jsteiner4000/Kabelsuchger-t/gehaeuse/konzept/ansicht_beide.png

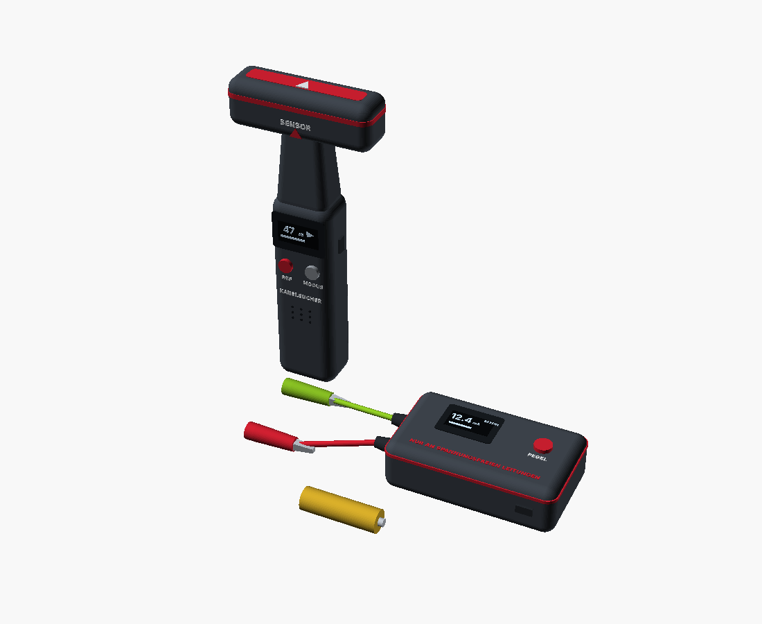
gehaeuse/konzept/ansicht_beide.png
