jsteiner4000/Kabelsuchger-t/gehaeuse/konzept/ansicht_hand.png

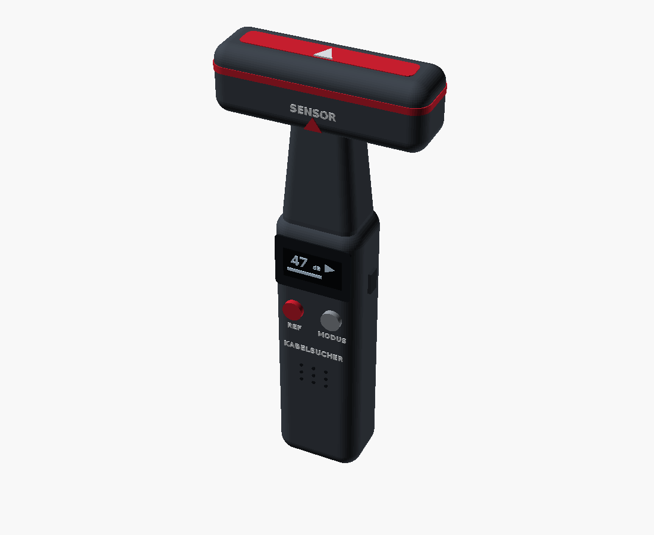
gehaeuse/konzept/ansicht_hand.png
