jsteiner4000/Kabelsuchger-t/hardware/kicad/handgeraet/bilder/handgeraet-bestueckung.png

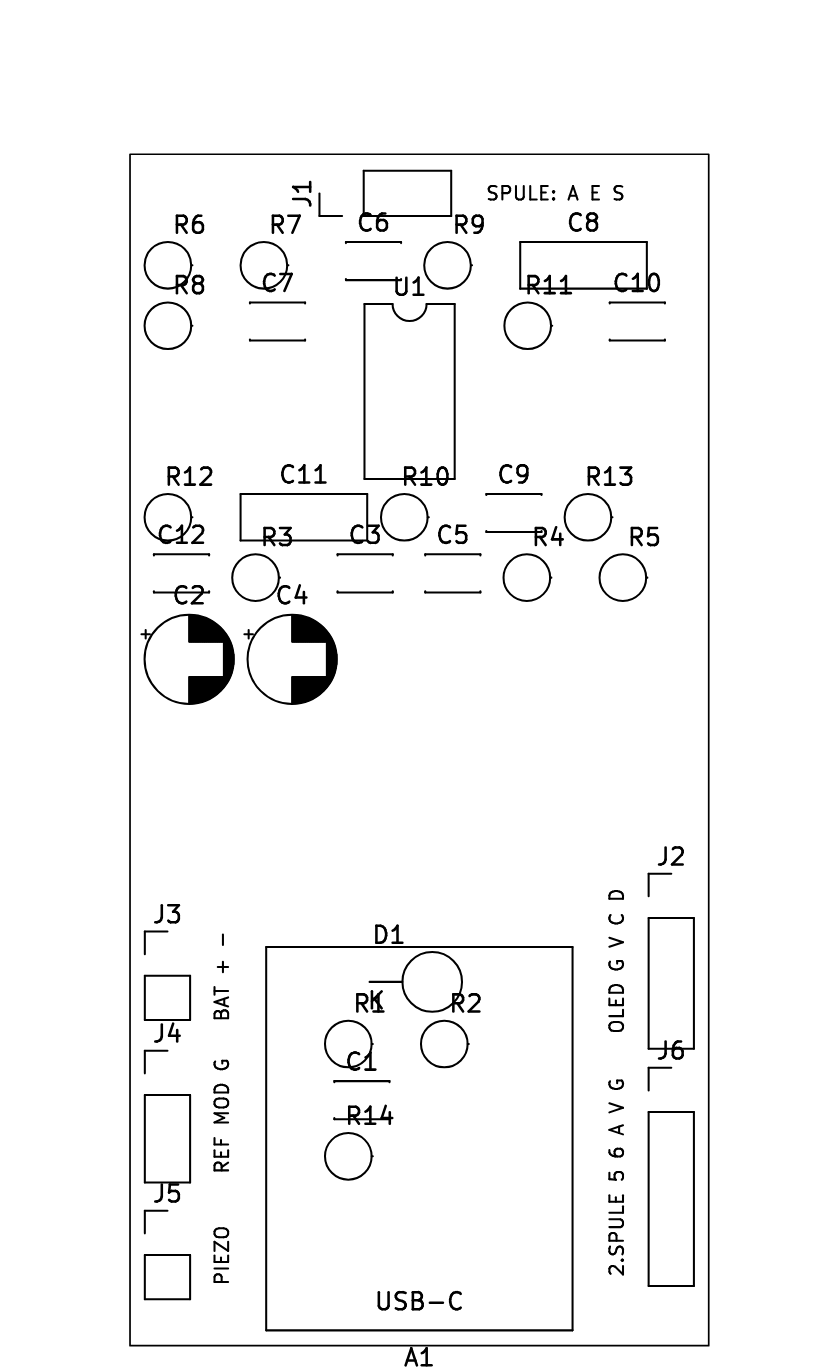
hardware/kicad/handgeraet/bilder/handgeraet-bestueckung.png
