jsteiner4000/Kabelsuchger-t/hardware/kicad/handgeraet/bilder/handgeraet-oben.png

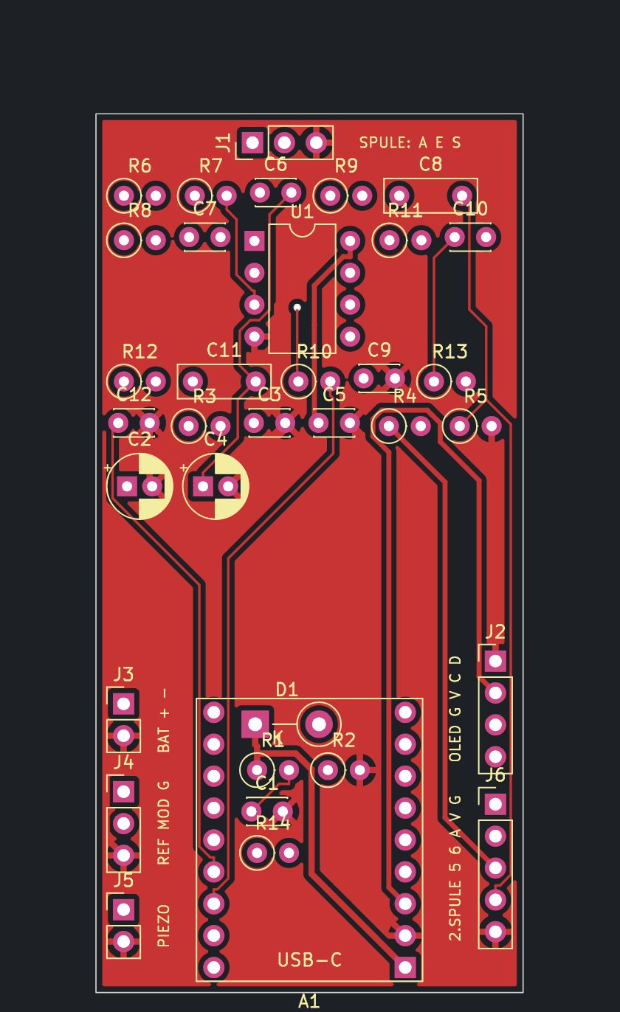
hardware/kicad/handgeraet/bilder/handgeraet-oben.png
