jsteiner4000/Kabelsuchger-t/hardware/kicad/handgeraet/bilder/handgeraet-unten.png

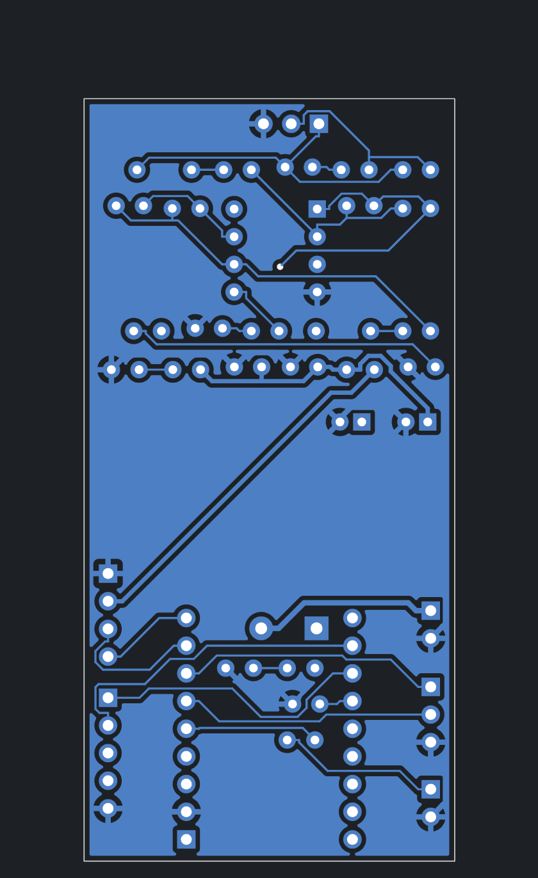
hardware/kicad/handgeraet/bilder/handgeraet-unten.png
