jsteiner4000/Kabelsuchger-t/hardware/kicad/sender/bilder/sender-bestueckung.png

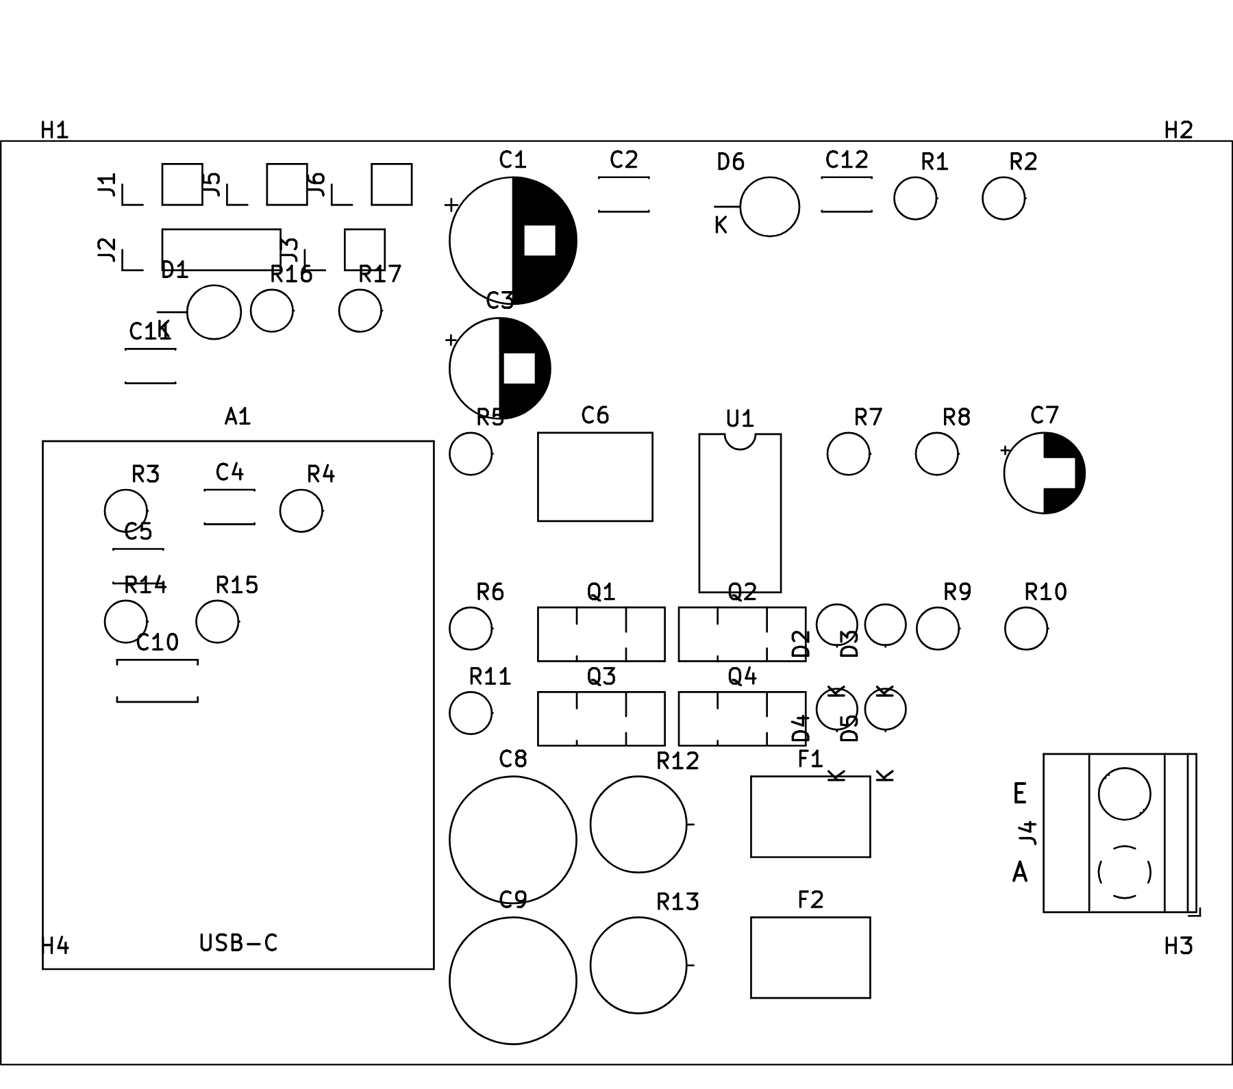
hardware/kicad/sender/bilder/sender-bestueckung.png
