jsteiner4000/Kabelsuchger-t/hardware/kicad/sender/bilder/sender-oben.png

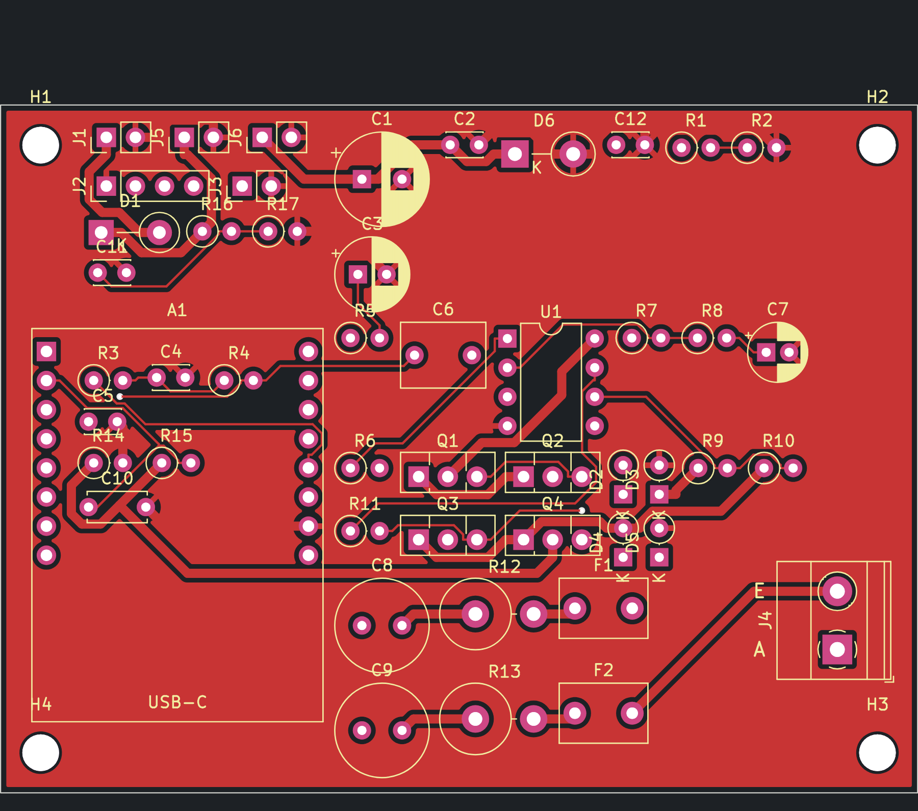
hardware/kicad/sender/bilder/sender-oben.png
