jsteiner4000/Kabelsuchger-t/hardware/kicad/sender/bilder/sender-unten.png

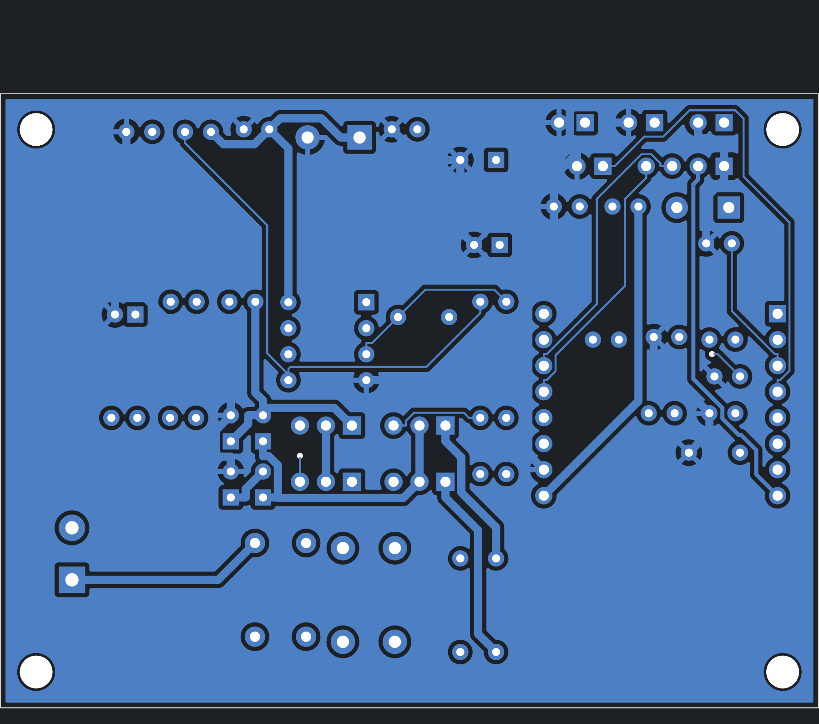
hardware/kicad/sender/bilder/sender-unten.png
