jsteiner4000/Kabelsuchger-t/hardware/handgeraet/spule/spulenkoerper_H.stl

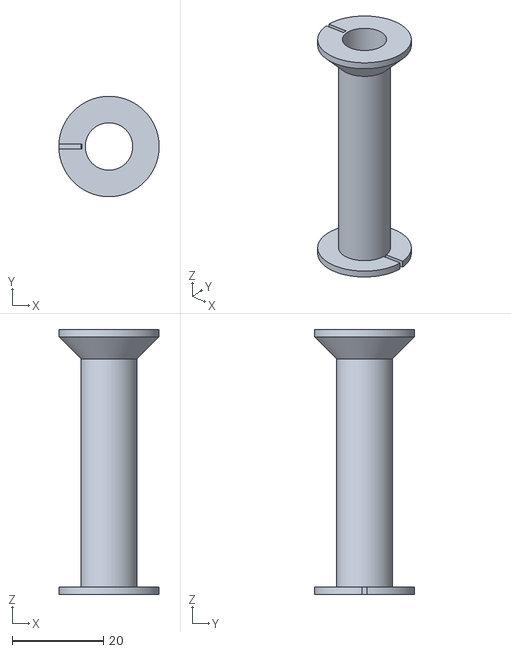
[picture p9: CAD file, 2026-10-13]
hardware/handgeraet/spule/spulenkoerper_H.stl
22.0 x 22.0 x 58.1
