jsteiner4000/Kabelsuchger-t/hardware/handgeraet/testaufbau/messkopf.stl

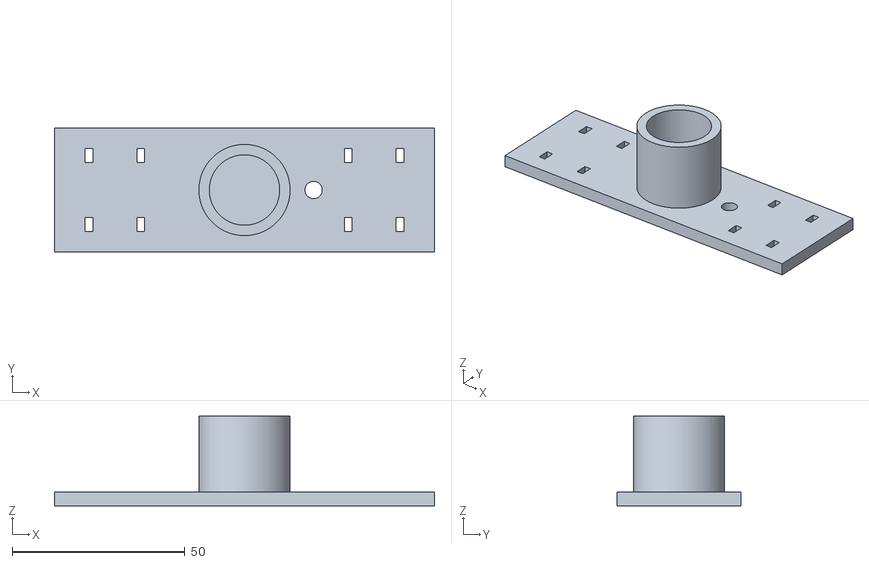
[picture p10: CAD file, 2026-10-13]
hardware/handgeraet/testaufbau/messkopf.stl
110.0 x 36.0 x 26.0
