jsteiner4000/Kabelsuchger-t/hardware/handgeraet/spule/wickeldorn.stl

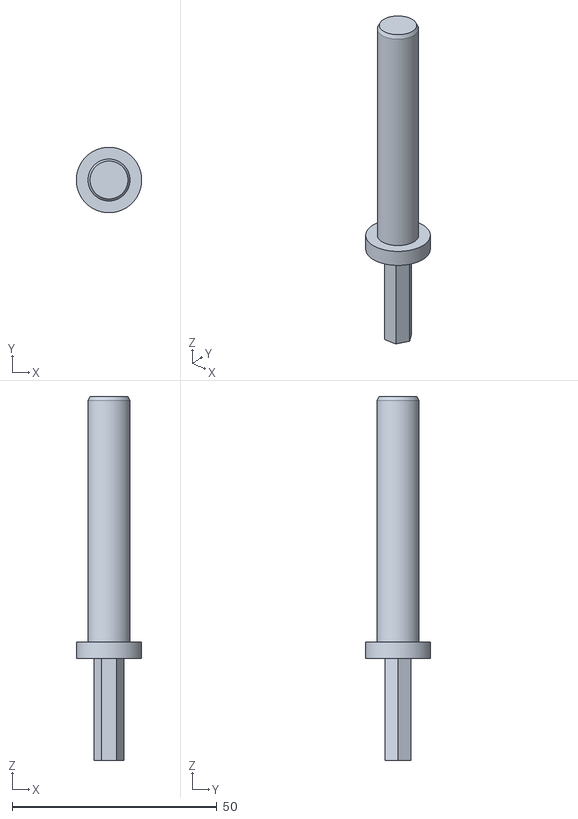
[picture p11: CAD file, 2026-10-13]
hardware/handgeraet/spule/wickeldorn.stl
16.0 x 16.0 x 89.0
