jsteiner4000/Kabelsuchger-t/hardware/handgeraet/spule/spulenkoerper_V.stl

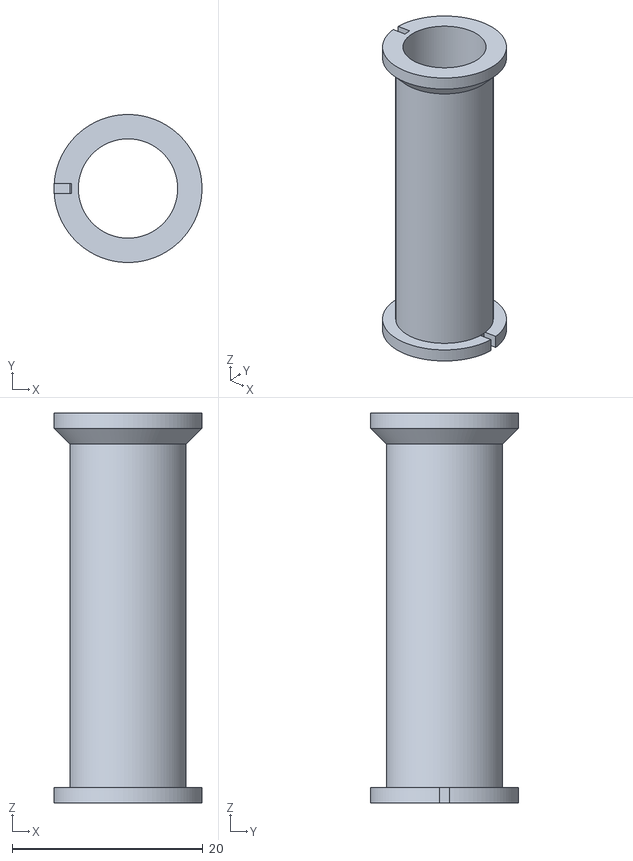
[picture p12: CAD file, 2026-10-13]
hardware/handgeraet/spule/spulenkoerper_V.stl
15.5 x 15.5 x 40.9
