jsteiner4000/Kabelsuchger-t/hardware/kicad/handgeraet/handgeraet-schaltplan.pdf

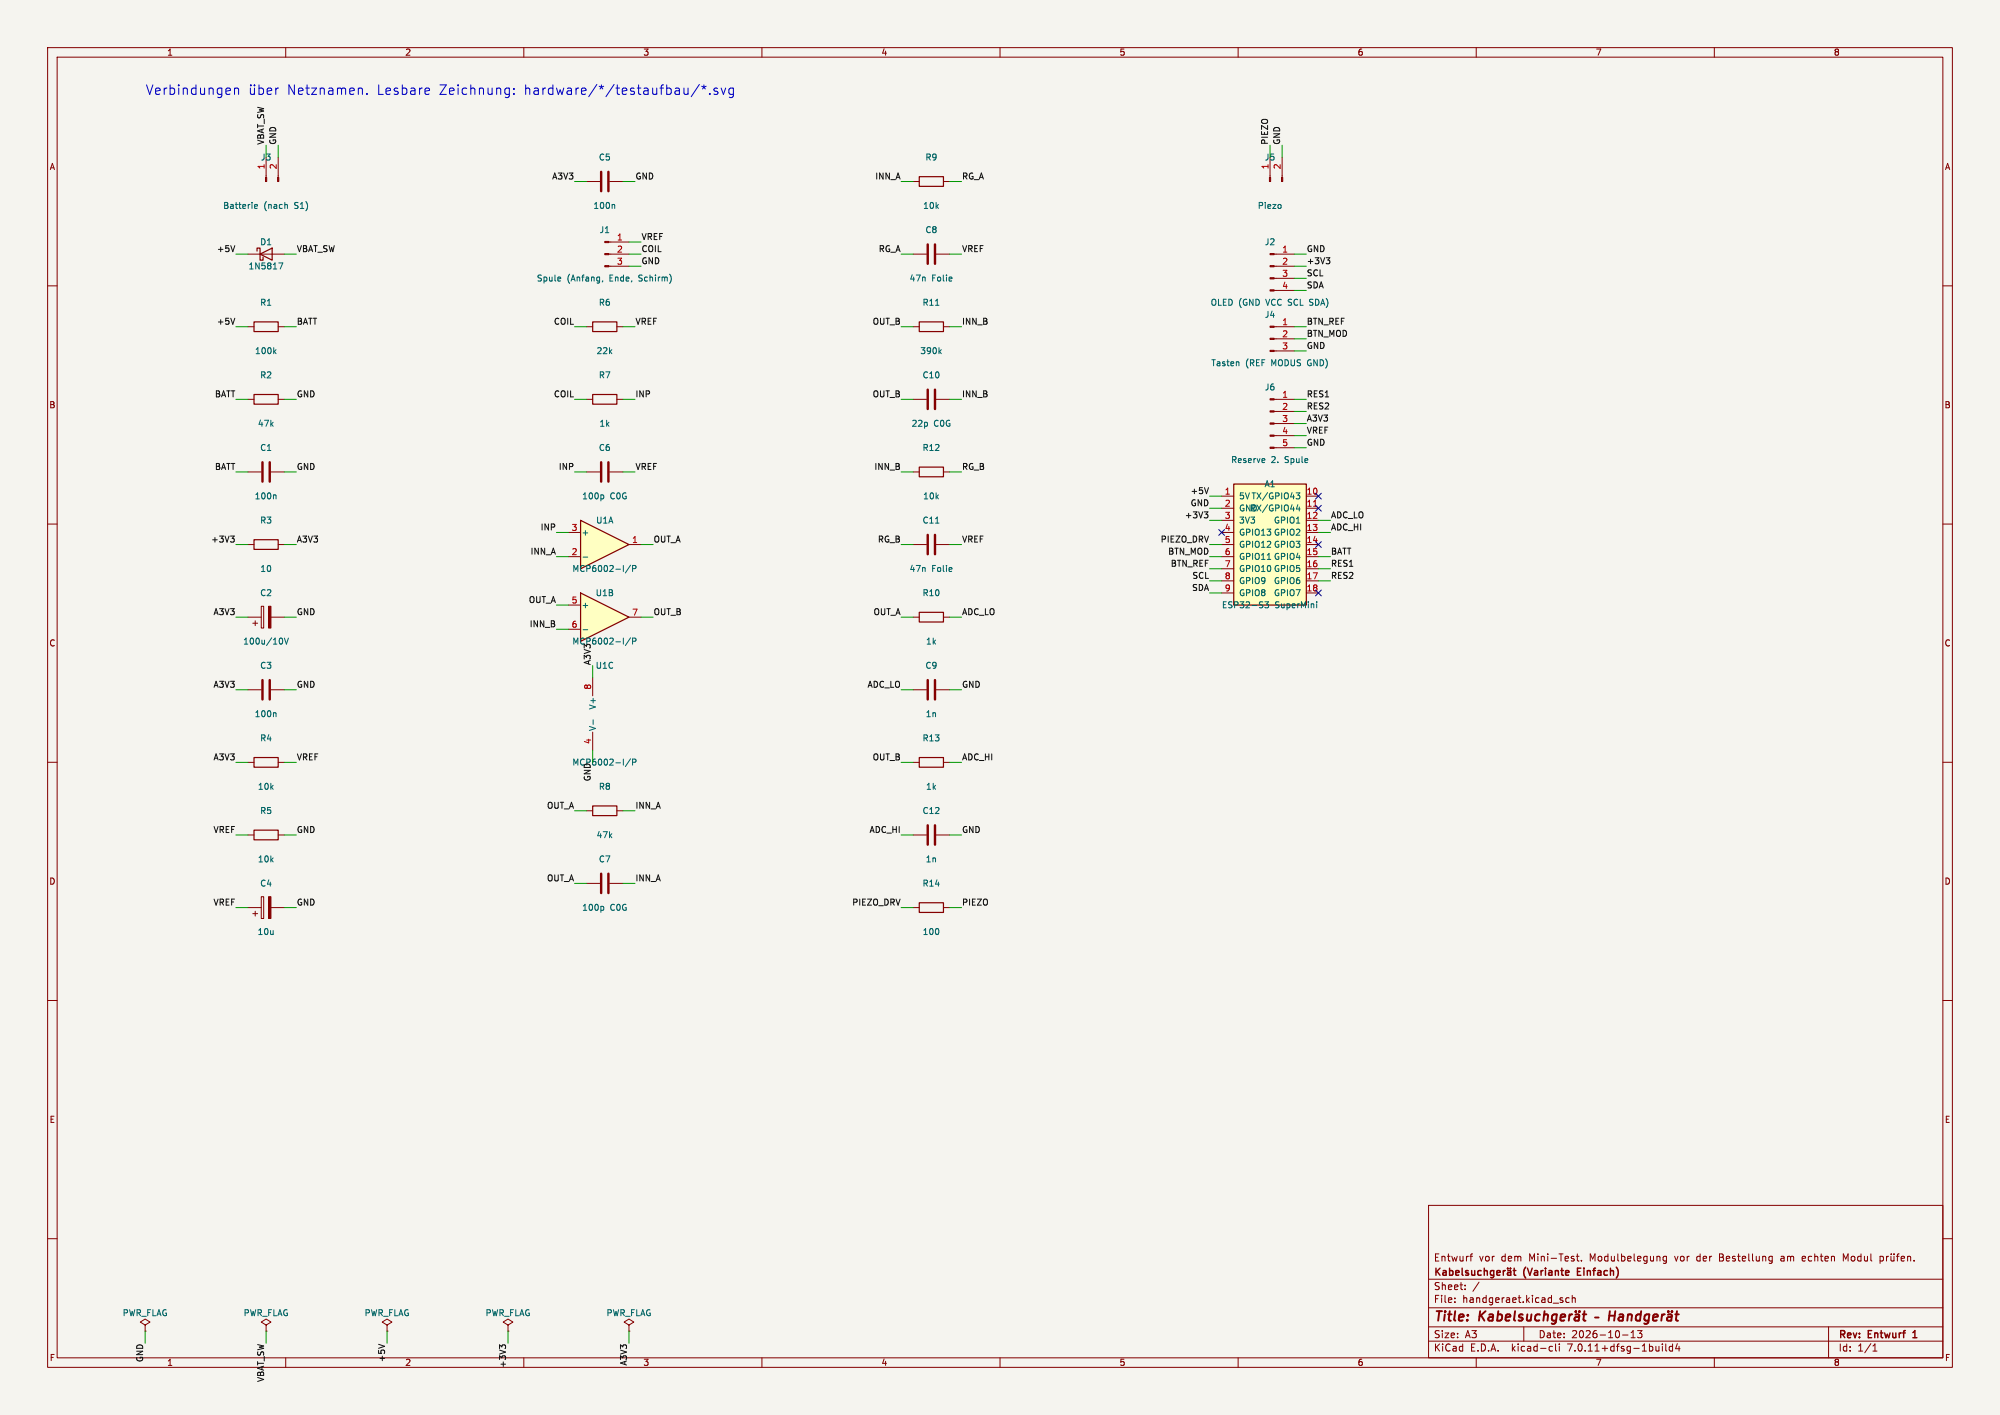
[picture p13: page 1]

J2 OLED (GND VCC SCL SDA) 1

J4 Tasten (REF MODUS GND) C4
