jsteiner4000/Kabelsuchger-t/hardware/kicad/sender/sender-schaltplan.pdf

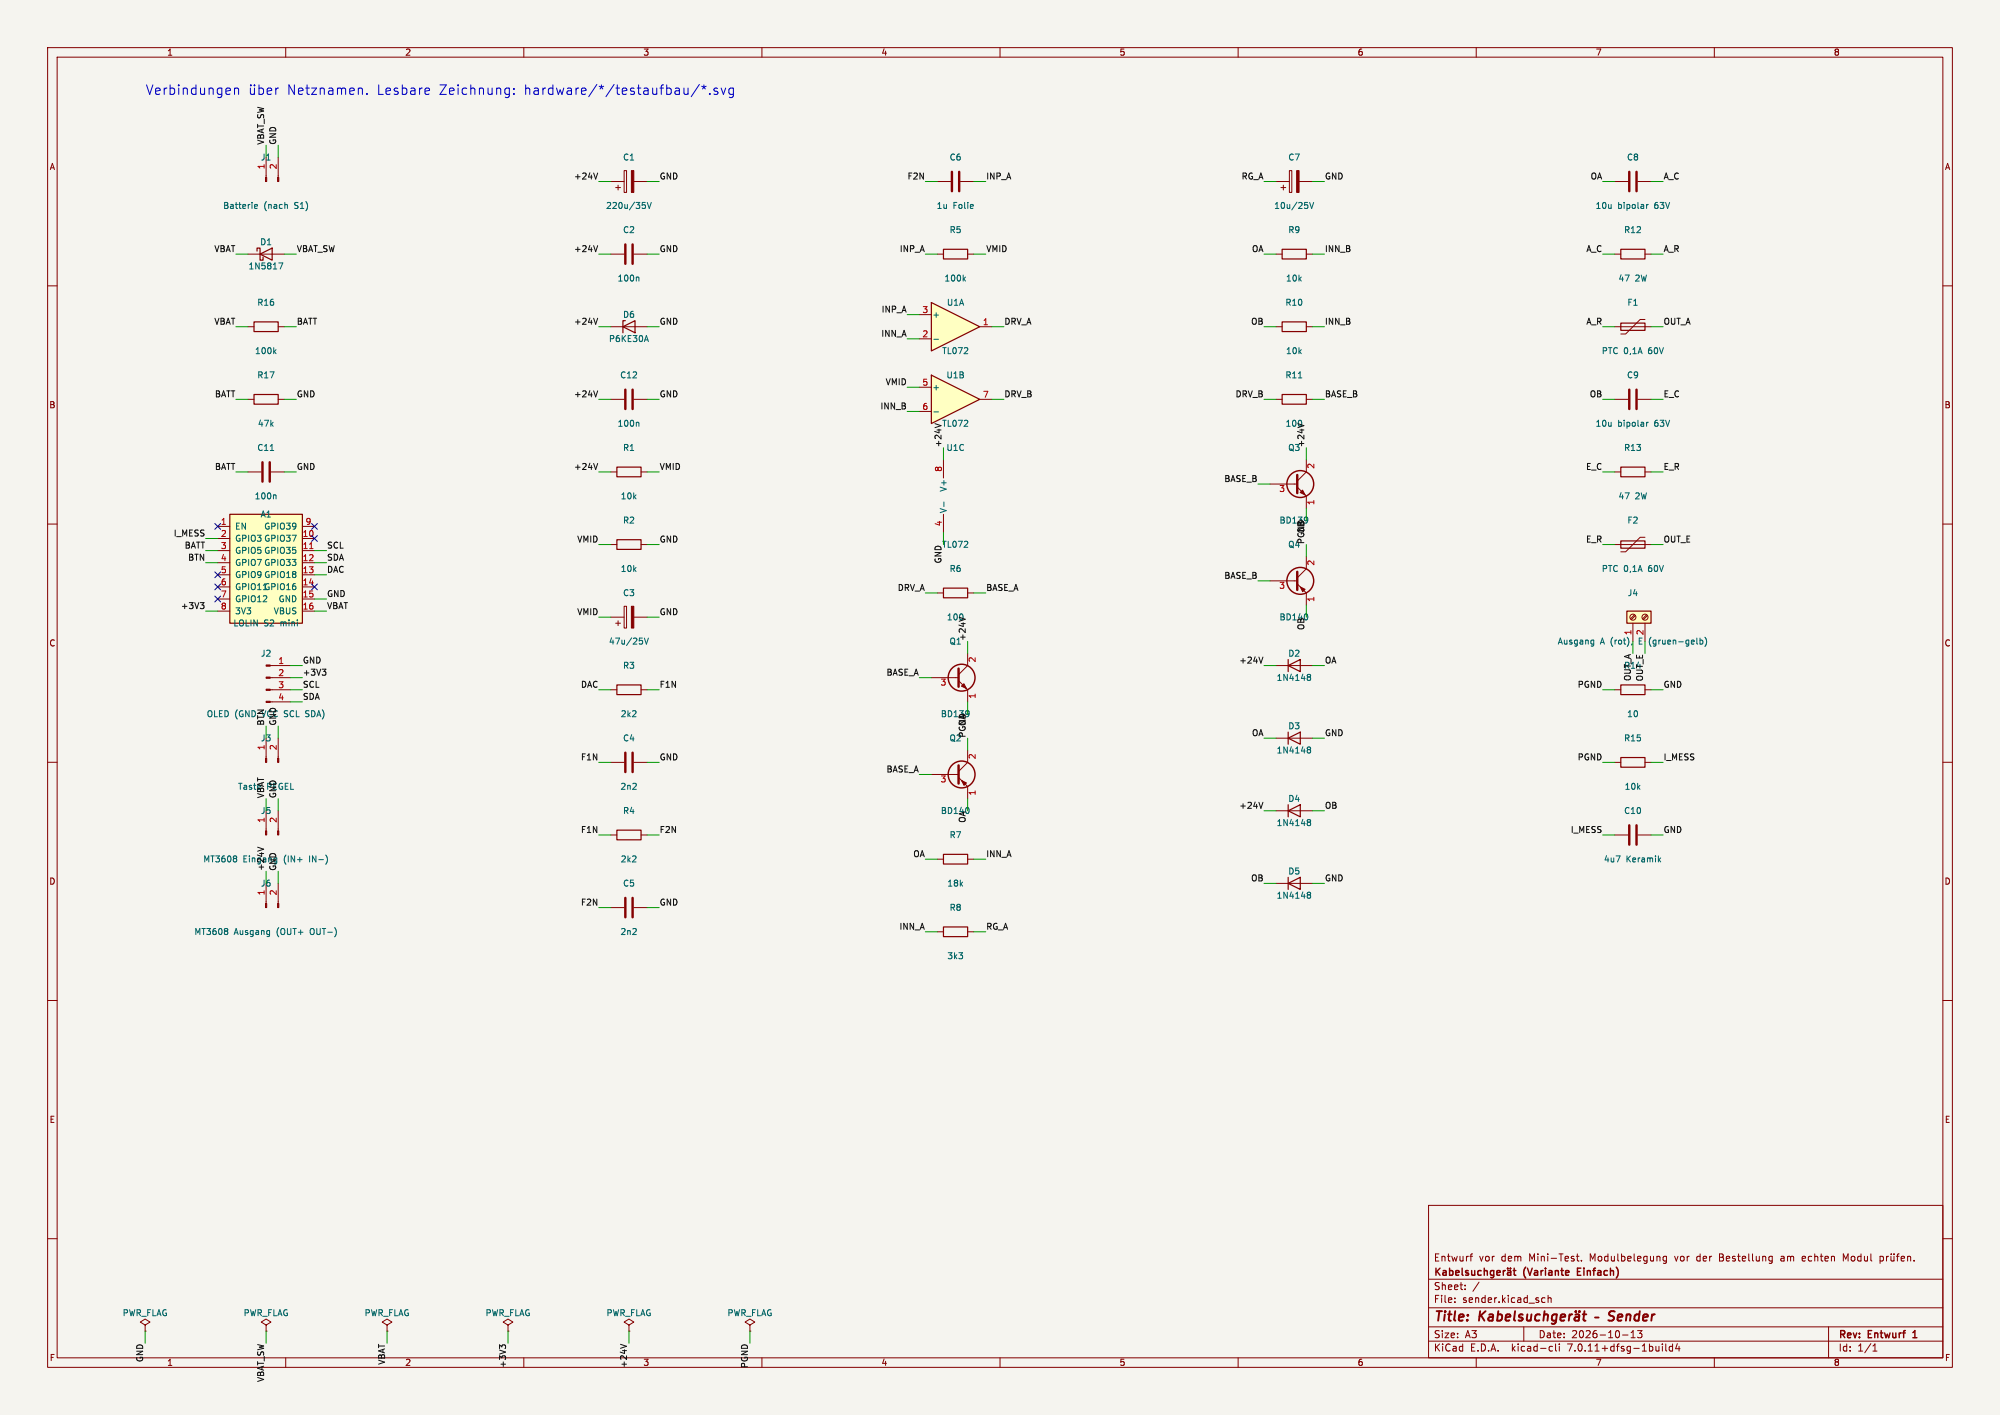
[picture p14: page 1]

J4 Ausgang A (rot), E (gruen-gelb)
