jsteiner4000/Kabelsuchger-t/hardware/kicad/sender/sender.kicad_pcb

## KiCad design hardware/kicad/sender/sender.kicad_pcb (2026-10-13)

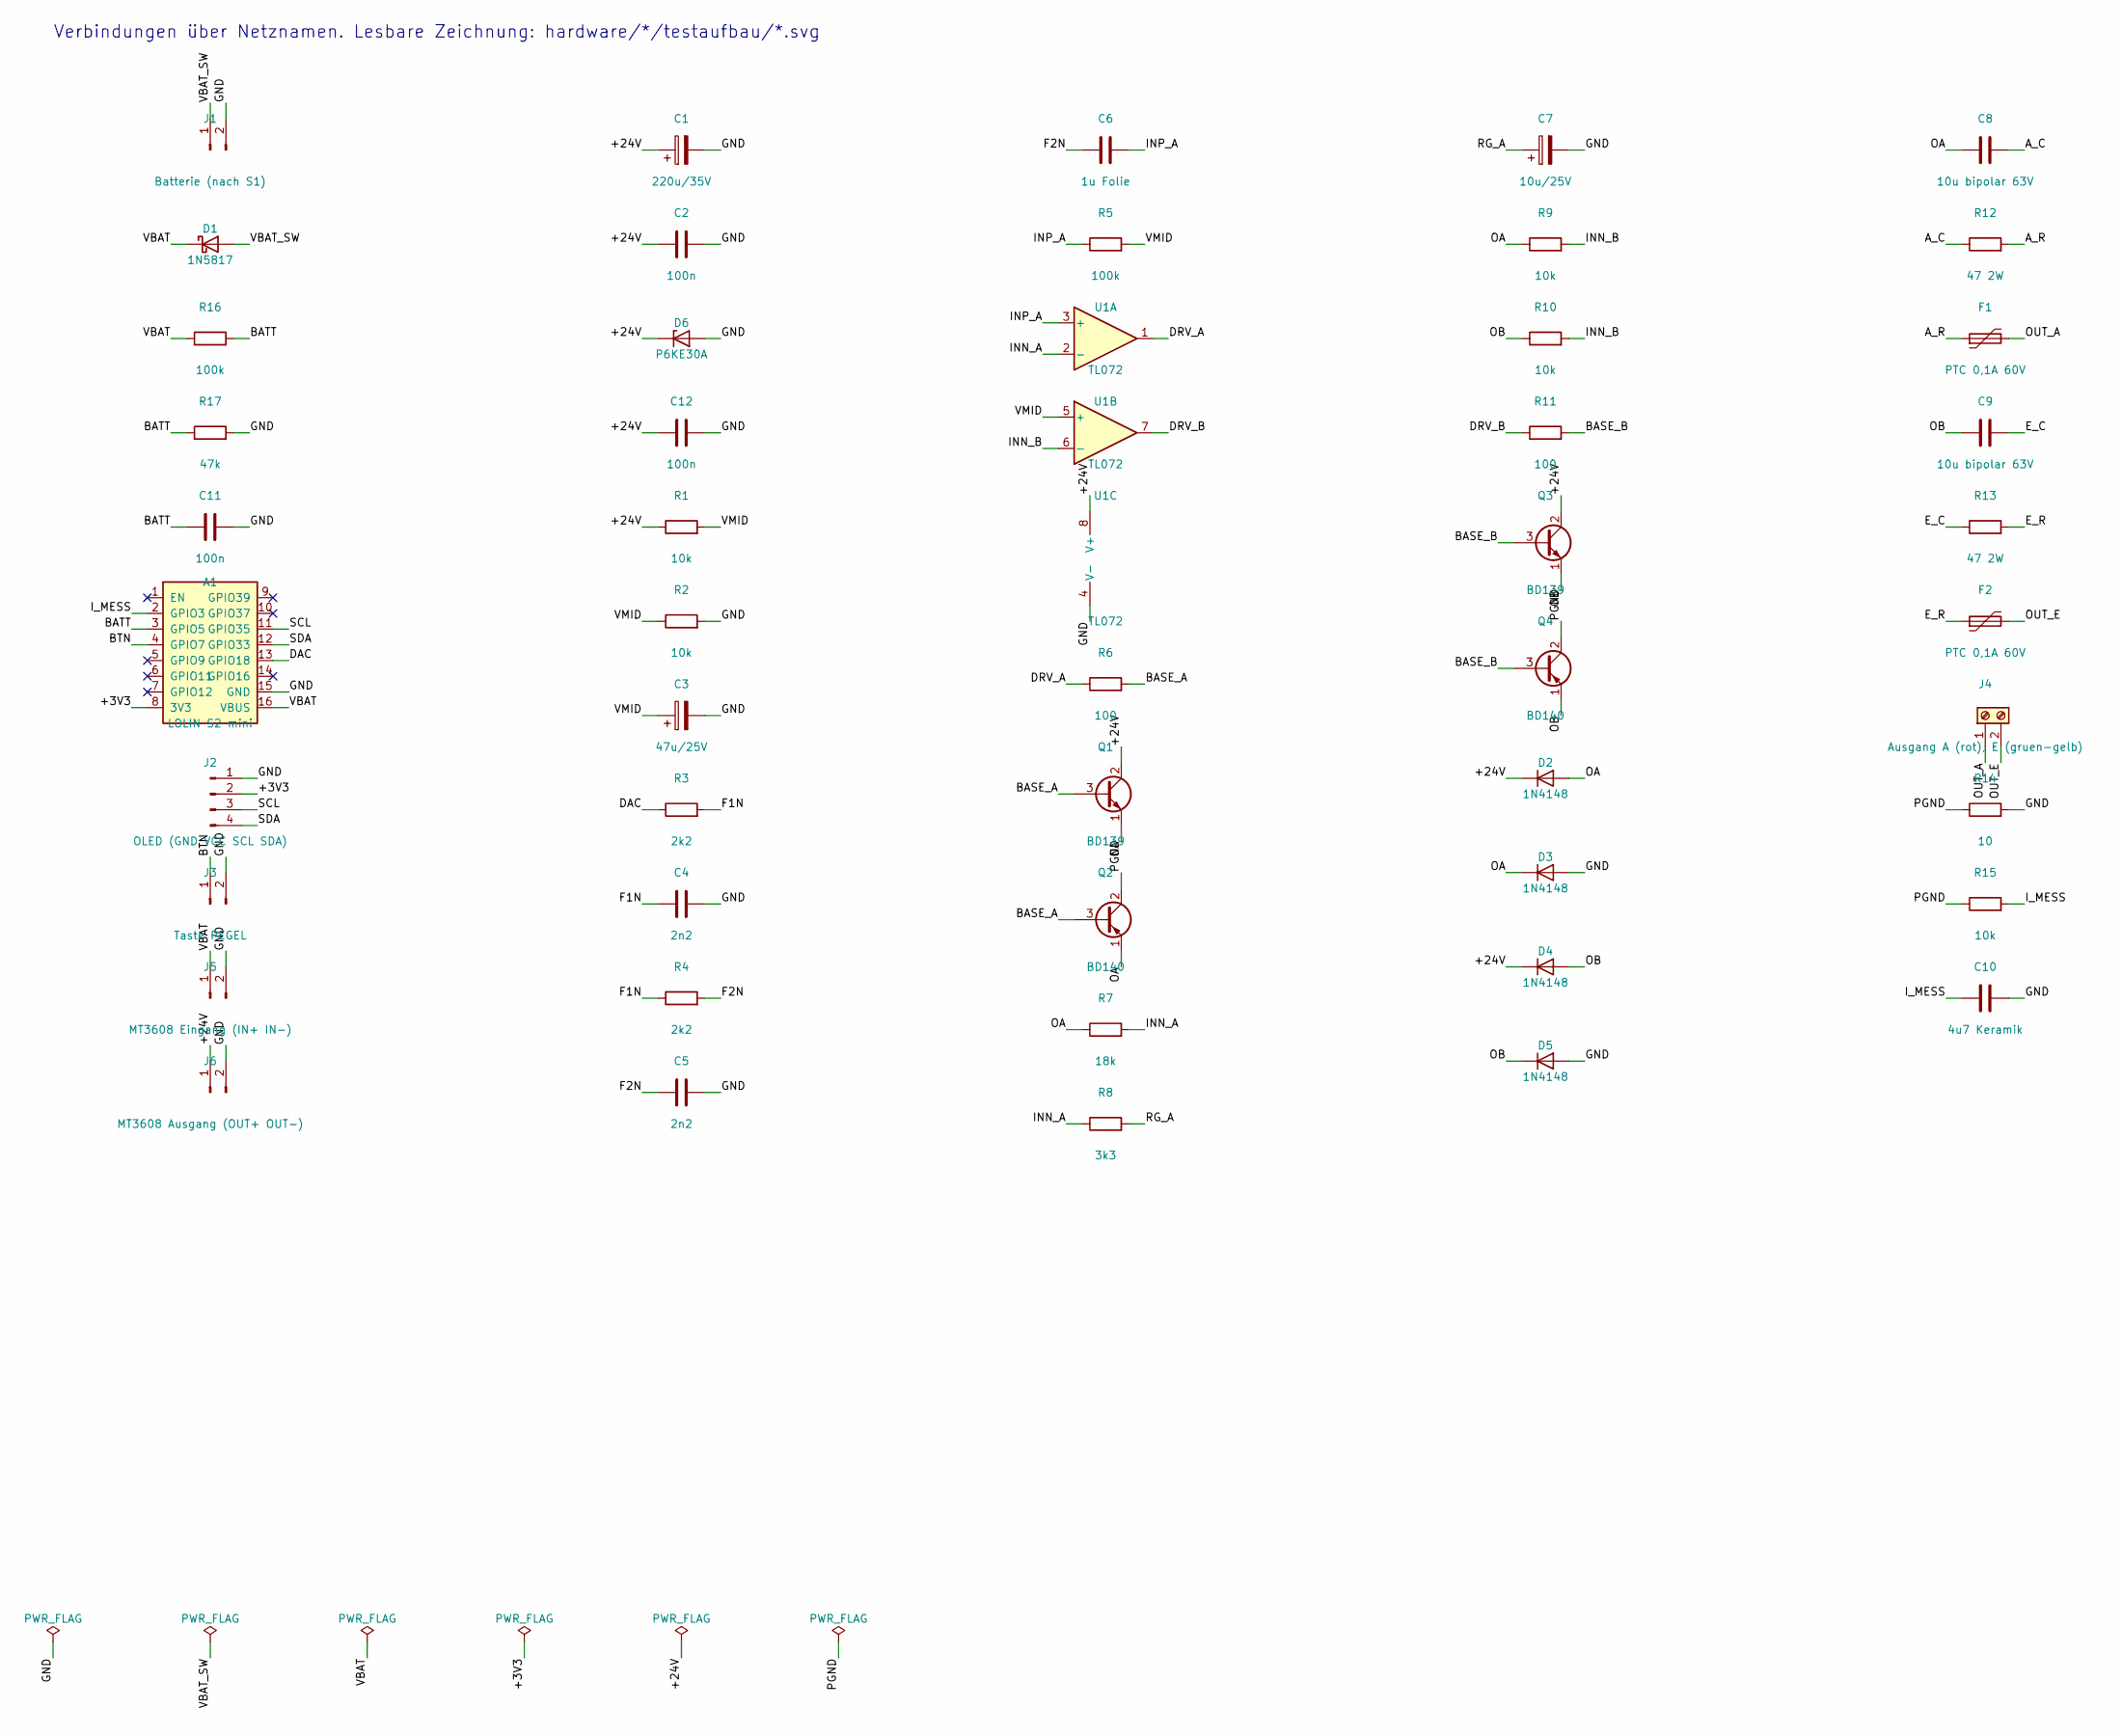
[picture p15: schematic sender.kicad_sch, Kabelsuchgerät – Sender]

Parts:
A1: LOLIN S2 mini; LOLIN_S2_mini
C1: 220u/35V; CP_Radial_D8.0mm_P3.50mm
C2, C11, C12: 100n; C_Disc_D3.0mm_W2.0mm_P2.50mm
C3: 47u/25V; CP_Radial_D6.3mm_P2.50mm
C4, C5: 2n2; C_Disc_D3.0mm_W2.0mm_P2.50mm
C6: 1u Folie; C_Rect_L7.2mm_W5.5mm_P5.00mm_FKS2_FKP2_MKS2_MKP2
C7: 10u/25V; CP_Radial_D5.0mm_P2.00mm
C8, C9: 10u bipolar 63V; C_Radial_D8.0mm_H11.5mm_P3.50mm
C10: 4u7 Keramik; C_Disc_D5.0mm_W2.5mm_P5.00mm
D1: 1N5817; D_DO-41_SOD81_P5.08mm_Vertical_KathodeUp
D2, D3, D4, D5: 1N4148; D_DO-35_SOD27_P2.54mm_Vertical_KathodeUp
D6: P6KE30A; D_DO-15_P5.08mm_Vertical_KathodeUp
F1, F2: PTC 0,1A 60V; C_Disc_D7.5mm_W5.0mm_P5.00mm
J1: Batterie (nach S1); PinHeader_1x02_P2.54mm_Vertical
J2: OLED (GND VCC SCL SDA); PinHeader_1x04_P2.54mm_Vertical
J3: Taste PEGEL; PinHeader_1x02_P2.54mm_Vertical
J4: Ausgang A (rot), E (gruen-gelb); TerminalBlock_Phoenix_MKDS-1,5-2-5.08_1x02_P5.08mm_Horizont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
J5: MT3608 Eingang (IN+ IN-); PinHeader_1x02_P2.54mm_Vertical
J6: MT3608 Ausgang (OUT+ OUT-); PinHeader_1x02_P2.54mm_Vertical
Q1, Q3: BD139; TO-126-3_Vertical
Q2, Q4: BD140; TO-126-3_Vertical
R1, R2, R9, R10, R15: 10k; R_Axial_DIN0207_L6.3mm_D2.5mm_P2.54mm_Vertical
R3, R4: 2k2; R_Axial_DIN0207_L6.3mm_D2.5mm_P2.54mm_Vertical
R5, R16: 100k; R_Axial_DIN0207_L6.3mm_D2.5mm_P2.54mm_Vertical
R6, R11: 100; R_Axial_DIN0207_L6.3mm_D2.5mm_P2.54mm_Vertical
R7: 18k; R_Axial_DIN0207_L6.3mm_D2.5mm_P2.54mm_Vertical
R8: 3k3; R_Axial_DIN0207_L6.3mm_D2.5mm_P2.54mm_Vertical
R12, R13: 47 2W; R_Axial_DIN0617_L17.0mm_D6.0mm_P5.08mm_Vertical
R14: 10; R_Axial_DIN0207_L6.3mm_D2.5mm_P2.54mm_Vertical
R17: 47k; R_Axial_DIN0207_L6.3mm_D2.5mm_P2.54mm_Vertical
U1: TL072; DIP-8_W7.62mm

Connections:
+3V3: A1.8 (3V3), J2.2
+24V: C1.1, C2.1, C12.1, D2.1 (K), D4.1 (K), D6.1 (K), J6.1, Q1.2 (C), Q3.2 (C), R1.1, U1.8 (V+)
A_C: C8.2, R12.1
A_R: F1.1, R12.2
BASE_A: Q1.3 (B), Q2.3 (B), R6.2
BASE_B: Q3.3 (B), Q4.3 (B), R11.2
BATT: A1.3 (GPIO5), C11.1, R16.2, R17.1
BTN: A1.4 (GPIO7), J3.1
DAC: A1.13 (GPIO18), R3.1
DRV_A: R6.1, U1.1
DRV_B: R11.1, U1.7
E_C: C9.2, R13.1
E_R: F2.1, R13.2
F1N: C4.1, R3.2, R4.1
F2N: C5.1, C6.1, R4.2
GND: A1.15 (GND), C1.2, C2.2, C3.2, C4.2, C5.2, C7.2, C10.2, C11.2, C12.2, D3.2 (A), D5.2 (A), D6.2 (A), J1.2, J2.1, J3.2, J5.2, J6.2, R2.2, R14.2, R17.2, U1.4 (V-)
INN_A: R7.2, R8.1, U1.2 (-)
INN_B: R9.2, R10.2, U1.6 (-)
INP_A: C6.2, R5.1, U1.3 (+)
I_MESS: A1.2 (GPIO3), C10.1, R15.2
OA: C8.1, D2.2 (A), D3.1 (K), Q1.1 (E), Q2.1 (E), R7.1, R9.1
OB: C9.1, D4.2 (A), D5.1 (K), Q3.1 (E), Q4.1 (E), R10.1
OUT_A: F1.2, J4.1
OUT_E: F2.2, J4.2
PGND: Q2.2 (C), Q4.2 (C), R14.1, R15.1
RG_A: C7.1, R8.2
SCL: A1.11 (GPIO35), J2.3
SDA: A1.12 (GPIO33), J2.4
VBAT: A1.16 (VBUS), D1.1 (K), J5.1, R16.1
VBAT_SW: D1.2 (A), J1.1
VMID: C3.1, R1.2, R2.1, R5.2, U1.5 (+)

Notes on the sheet:
Verbindungen über Netznamen. Lesbare Zeichnung: hardware/*/testaufbau/*.svg

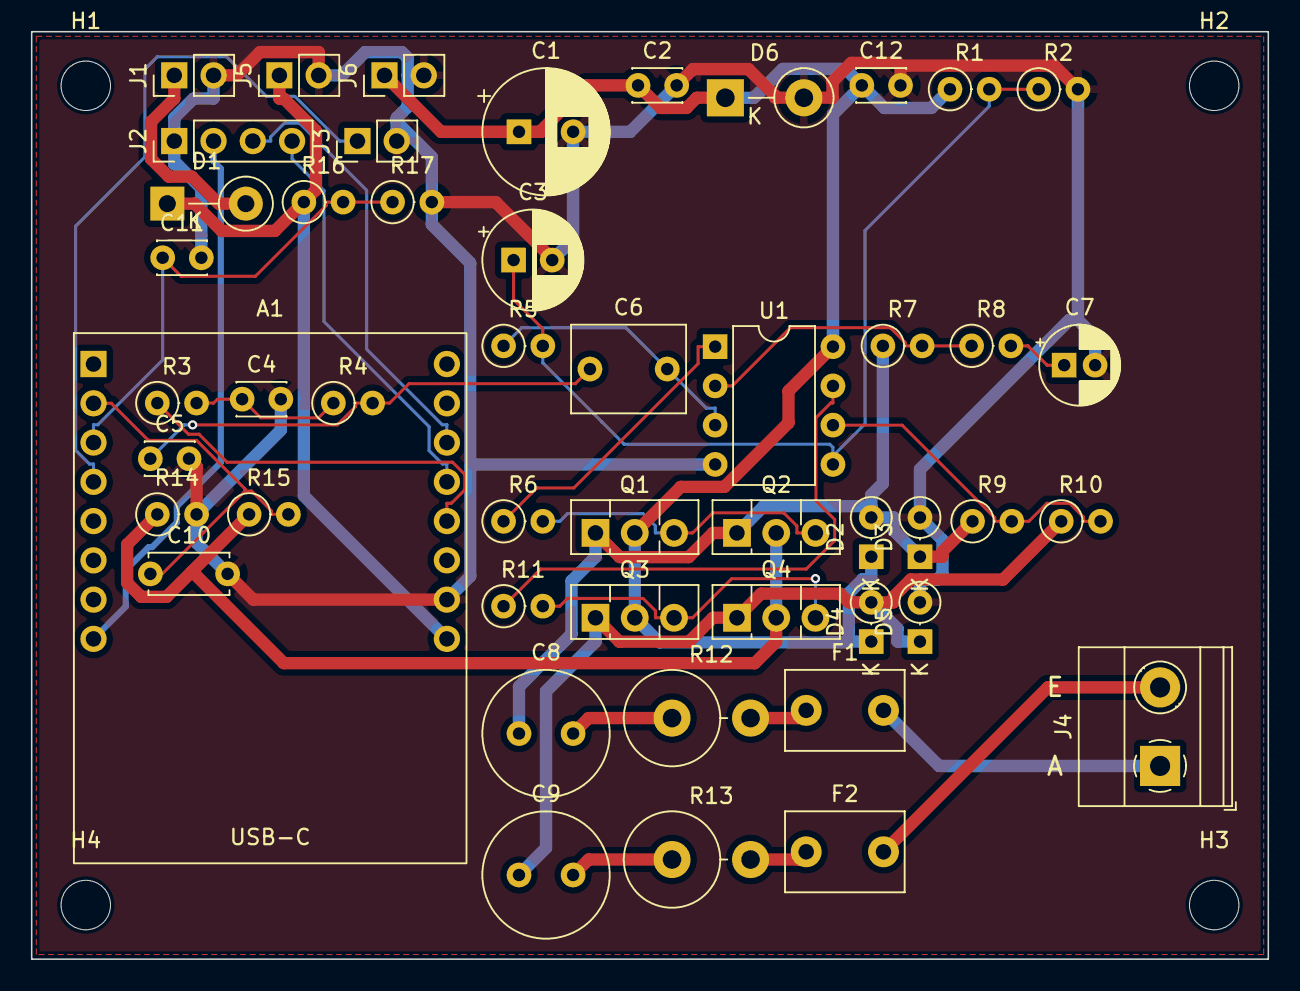
[picture p16: board sender.kicad_pcb from above]

Board: 2 copper layers, 80.0 x 60.0 mm, 53 parts (0 on the bottom side), 31 nets.

Other parts of the board:
H1, H2, H3, H4: M3; MountingHole_3.2mm_M3
