jsteiner4000/Kabelsuchger-t/hardware/kicad/handgeraet/handgeraet.kicad_pcb

## KiCad design hardware/kicad/handgeraet/handgeraet.kicad_pcb (2026-10-13)

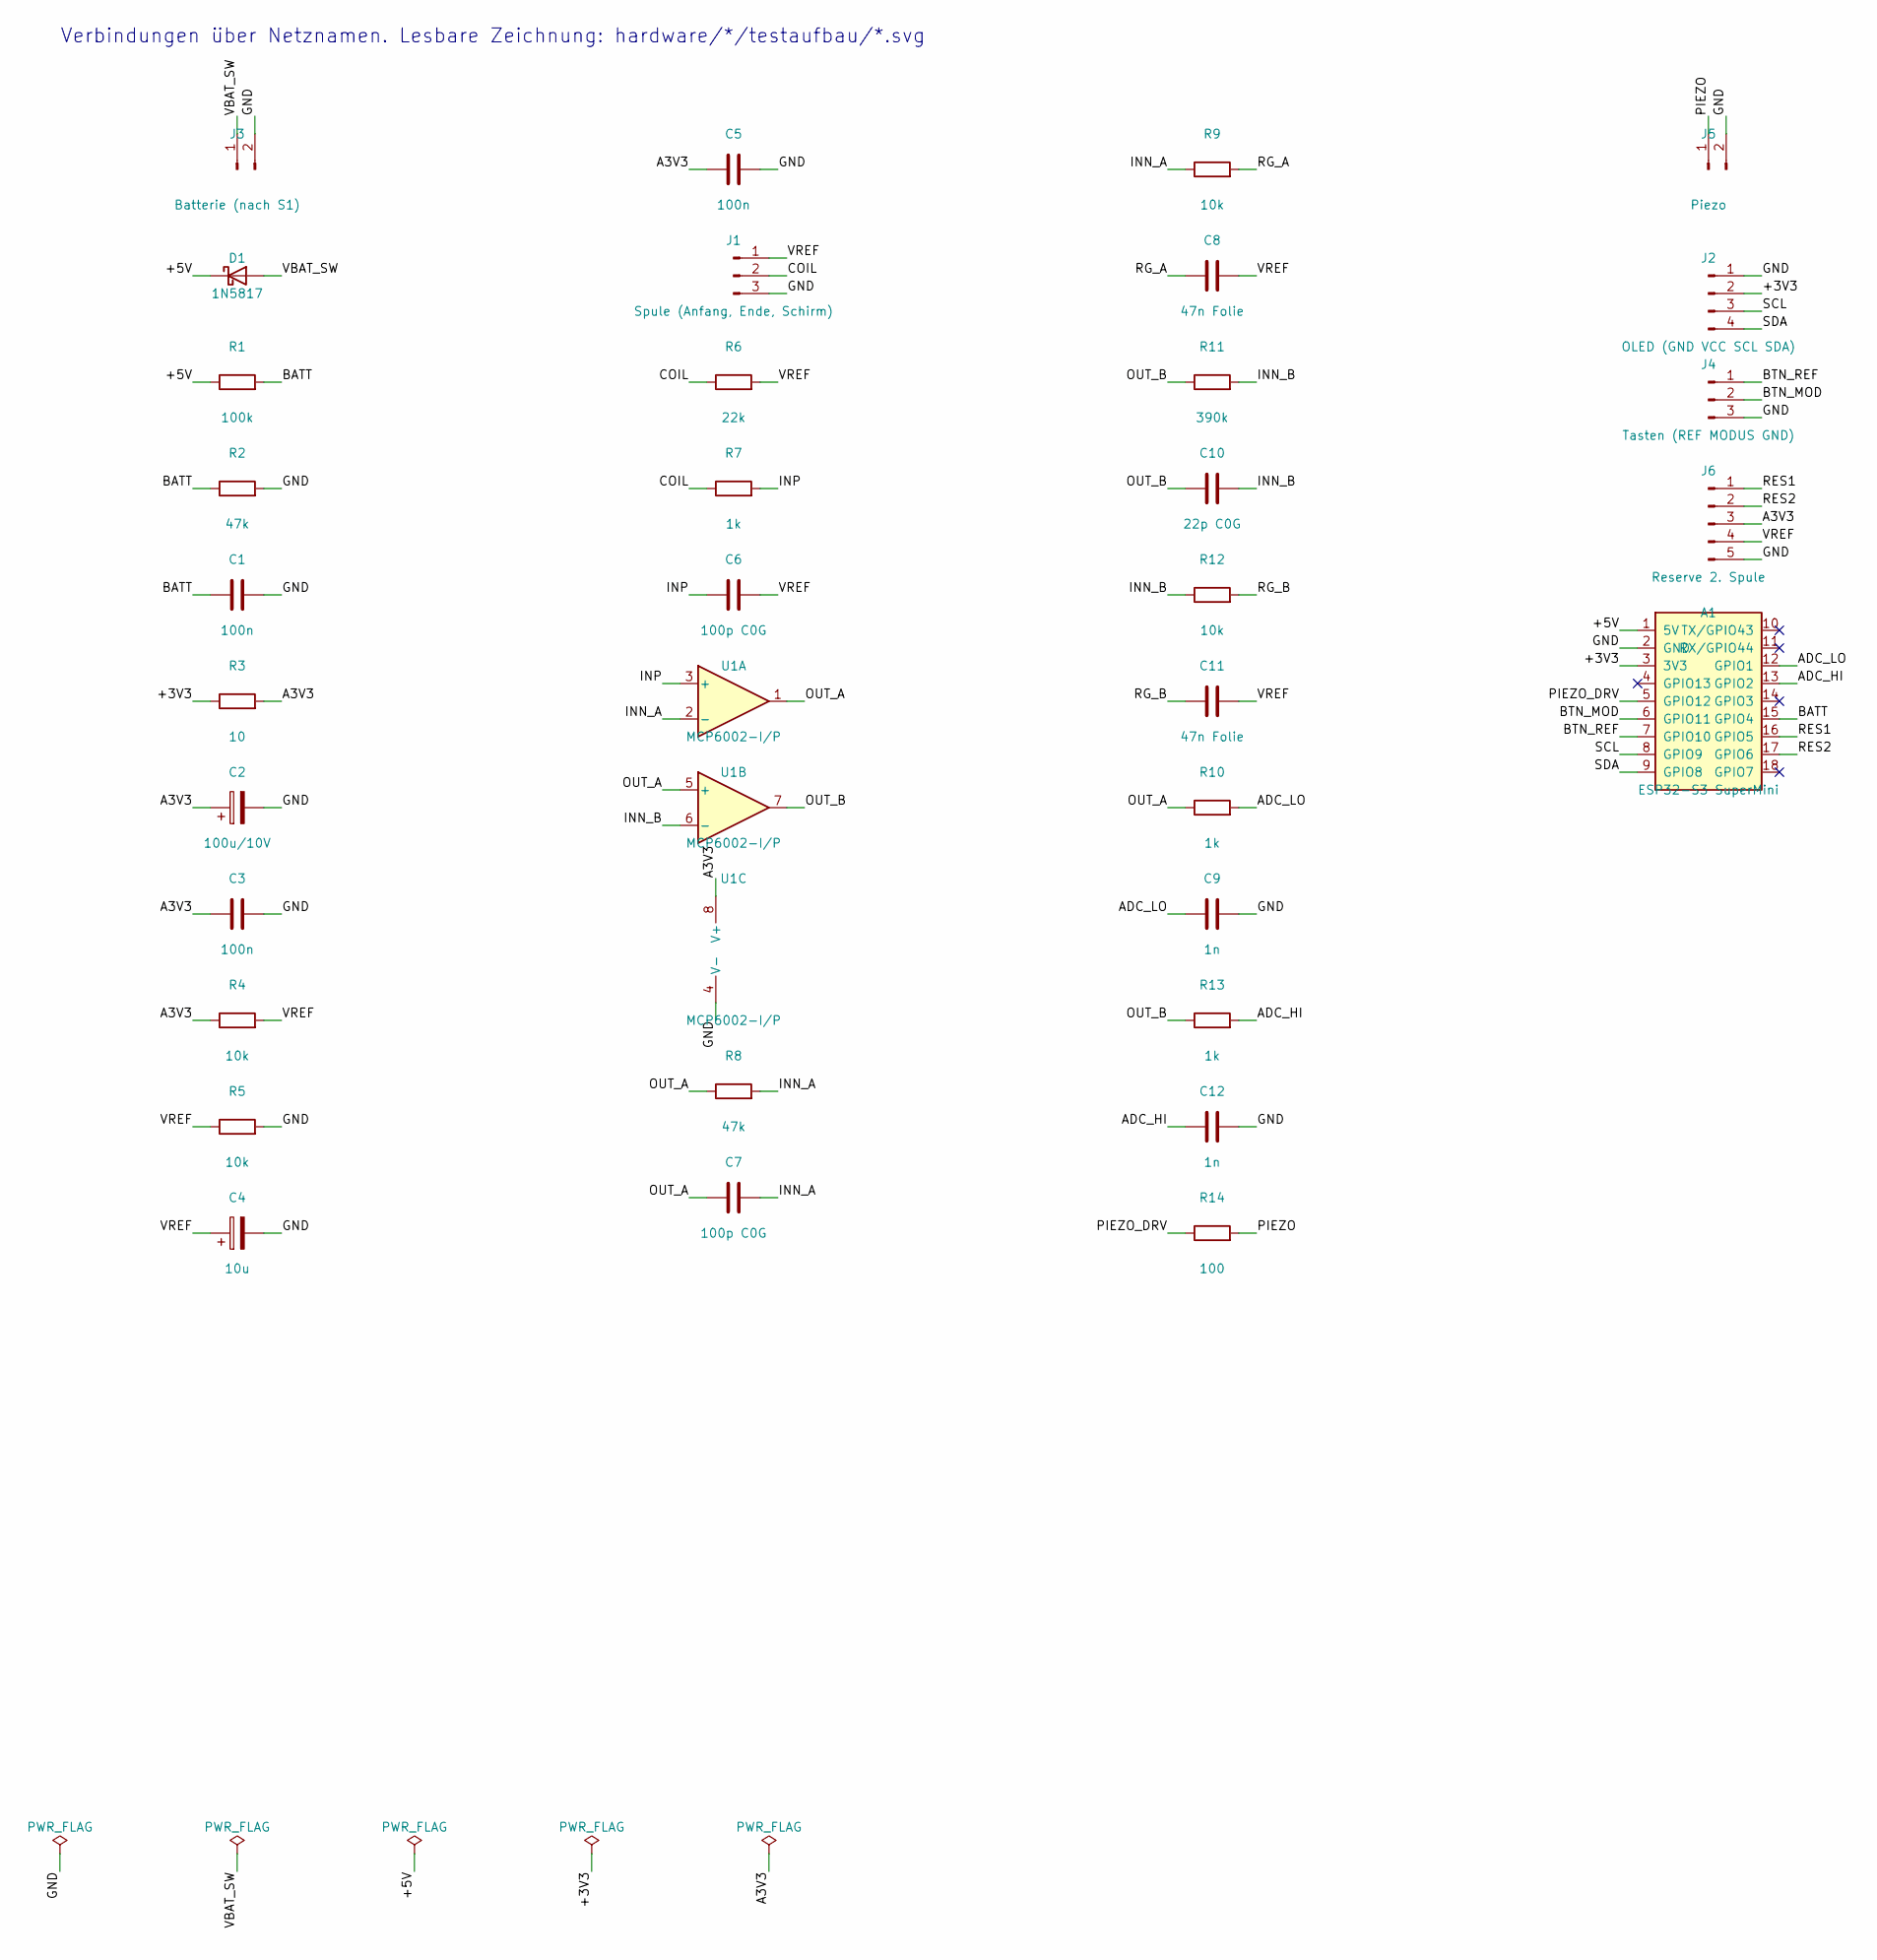
[picture p17: schematic handgeraet.kicad_sch, Kabelsuchgerät – Handgerät]

Parts:
A1: ESP32-S3 SuperMini; ESP32-S3_SuperMini
C1, C3, C5: 100n; C_Disc_D3.0mm_W2.0mm_P2.50mm
C2: 100u/10V; CP_Radial_D5.0mm_P2.00mm
C4: 10u; CP_Radial_D5.0mm_P2.00mm
C6, C7: 100p C0G; C_Disc_D3.0mm_W2.0mm_P2.50mm
C8, C11: 47n Folie; C_Rect_L7.2mm_W2.5mm_P5.00mm_FKS2_FKP2_MKS2_MKP2
C9, C12: 1n; C_Disc_D3.0mm_W2.0mm_P2.50mm
C10: 22p C0G; C_Disc_D3.0mm_W2.0mm_P2.50mm
D1: 1N5817; D_DO-41_SOD81_P5.08mm_Vertical_KathodeUp
J1: Spule (Anfang, Ende, Schirm); PinHeader_1x03_P2.54mm_Vertical
J2: OLED (GND VCC SCL SDA); PinHeader_1x04_P2.54mm_Vertical
J3: Batterie (nach S1); PinHeader_1x02_P2.54mm_Vertical
J4: Tasten (REF MODUS GND); PinHeader_1x03_P2.54mm_Vertical
J5: Piezo; PinHeader_1x02_P2.54mm_Vertical
J6: Reserve 2. Spule; PinHeader_1x05_P2.54mm_Vertical
R1: 100k; R_Axial_DIN0207_L6.3mm_D2.5mm_P2.54mm_Vertical
R2, R8: 47k; R_Axial_DIN0207_L6.3mm_D2.5mm_P2.54mm_Vertical
R3: 10; R_Axial_DIN0207_L6.3mm_D2.5mm_P2.54mm_Vertical
R4, R5, R9, R12: 10k; R_Axial_DIN0207_L6.3mm_D2.5mm_P2.54mm_Vertical
R6: 22k; R_Axial_DIN0207_L6.3mm_D2.5mm_P2.54mm_Vertical
R7, R10, R13: 1k; R_Axial_DIN0207_L6.3mm_D2.5mm_P2.54mm_Vertical
R11: 390k; R_Axial_DIN0207_L6.3mm_D2.5mm_P2.54mm_Vertical
R14: 100; R_Axial_DIN0207_L6.3mm_D2.5mm_P2.54mm_Vertical
U1: MCP6002-I/P; DIP-8_W7.62mm

Connections:
+3V3: A1.3 (3V3), J2.2, R3.1
+5V: A1.1 (5V), D1.1 (K), R1.1
A3V3: C2.1, C3.1, C5.1, J6.3, R3.2, R4.1, U1.8 (V+)
ADC_HI: A1.13 (GPIO2), C12.1, R13.2
ADC_LO: A1.12 (GPIO1), C9.1, R10.2
BATT: A1.15 (GPIO4), C1.1, R1.2, R2.1
BTN_MOD: A1.6 (GPIO11), J4.2
BTN_REF: A1.7 (GPIO10), J4.1
COIL: J1.2, R6.1, R7.1
GND: A1.2 (GND), C1.2, C2.2, C3.2, C4.2, C5.2, C9.2, C12.2, J1.3, J2.1, J3.2, J4.3, J5.2, J6.5, R2.2, R5.2, U1.4 (V-)
INN_A: C7.2, R8.2, R9.1, U1.2 (-)
INN_B: C10.2, R11.2, R12.1, U1.6 (-)
INP: C6.1, R7.2, U1.3 (+)
OUT_A: C7.1, R8.1, R10.1, U1.1, U1.5 (+)
OUT_B: C10.1, R11.1, R13.1, U1.7
PIEZO: J5.1, R14.2
PIEZO_DRV: A1.5 (GPIO12), R14.1
RES1: A1.16 (GPIO5), J6.1
RES2: A1.17 (GPIO6), J6.2
RG_A: C8.1, R9.2
RG_B: C11.1, R12.2
SCL: A1.8 (GPIO9), J2.3
SDA: A1.9 (GPIO8), J2.4
VBAT_SW: D1.2 (A), J3.1
VREF: C4.1, C6.2, C8.2, C11.2, J1.1, J6.4, R4.2, R5.1, R6.2

Notes on the sheet:
Verbindungen über Netznamen. Lesbare Zeichnung: hardware/*/testaufbau/*.svg

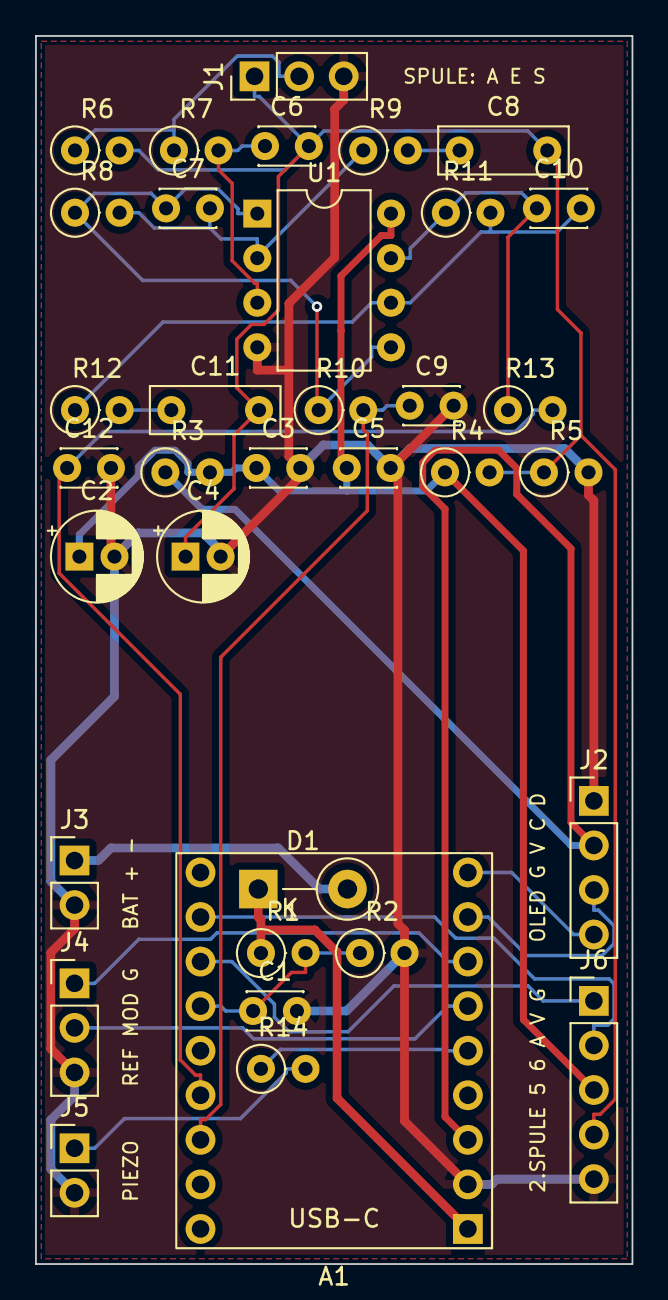
[picture p18: board handgeraet.kicad_pcb from above]

Board: 2 copper layers, 34.0 x 70.0 mm, 35 parts (0 on the bottom side), 25 nets.
