jsteiner4000/Kabelsuchger-t/firmware/machbarkeit/test_host/stubs/soc/soc_caps.h

// Ersatz: Werte für den ESP32-S3 aus ESP-IDF v5.3 soc/esp32s3/include/soc/soc_caps.h
#pragma once
#define SOC_ADC_DIGI_RESULT_BYTES (4)
#define SOC_ADC_DIGI_MAX_BITWIDTH (12)
#define SOC_ADC_SAMPLE_FREQ_THRES_HIGH 83333
#define SOC_ADC_SAMPLE_FREQ_THRES_LOW 611
