jsteiner4000/Kabelsuchger-t/(commit log)

2026-10-13 Phase 1: Projektstruktur, Lastenheft-Entwurf v0.1 und visuelle Übersicht
    - Ordnerstruktur laut Auftrag (docs, hardware, firmware, gehaeuse)
    - docs/lastenheft.md: Anforderungen (Muss/Soll/Kann), Abnahmetests,
    physikalische Grenzen, offene Fragen F-01 bis F-20
    - docs/lastenheft-uebersicht.html: visuelle Übersicht des Lastenhefts
    - docs/entscheidungen.md: erste Entscheidungen und offene Punkte
    - stueckliste.csv: Kopfzeile (Trennzeichen Semikolon)
    Claude-Session: https://claude.ai/code/session_01Kp3vnt9RjMWtJNc2VerSxX
    [stueckliste.csv]
2026-10-13 Lastenheft v1.0: Antworten aus Phase 1 eingearbeitet
    - Kein SMD-Löten: nur THT und fertige Module (E-01, E-006)
    - OLED in beiden Geräten, Anzeige-Grundsätze A-01 bis A-03 (E-007)
    - Schwerpunkt Trasse und Unterputz, neue Muss-Anforderung U-13
    Selektivität in Trassen (E-013)
    - Leitungslänge 300 m Muss / 500 m Soll (E-010)
    - Durchgangstest auf Soll, NYM als Kann mit 5 Sicherheitsregeln (E-011)
    - Fremdspannung 60 V DC / 50 V AC, kein 230-V-Schutz gefordert (E-012)
    - Kein Kopfhöreranschluss (E-008), AA-Versorgung und Abschaltzeiten (E-009)
    - KiCad als Ziel, Werkzeugfrage bis Phase 5 offen (E-014)
    - Neue Abnahmetests T-14 bis T-16; Übersichtsseite aktualisiert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
2026-10-13 Phase 2: Konzept v1.0 mit Feldrechnung und visueller Übersicht
    - docs/konzept.md: Magnetfeld als Hauptprinzip, Einspeisemodi G/A/P
    (Bündel gegen Erde als Hauptmodus), Zweiton-Signal mit Stromrichtung,
    drei Frequenzsätze, Handgerät mit PCM1808 und Lock-in-Auswertung,
    Sender mit Lastbild, Durchgang und Fremdspannungssperre, Varianten
    A/B/C, realistische Reichweiten, Zielwerte T-01 bis T-16, Budget
    - docs/berechnungen/feldmodell.py: Feld- und Reichweitenrechnung
    - docs/konzept-uebersicht.html: Diagramme, Blockschaltbilder, Bauform,
    Display-Entwürfe, Reichweiten, Kostenvergleich
    - docs/entscheidungen.md: Vorschläge E-015 bis E-027
    - Lastenheft: als freigegeben markiert, Antworten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
2026-10-13 Phase 3: Machbarkeitstest – Anleitung, Test-Firmware, Druckteile, Schaltpläne
    - docs/machbarkeitstest.md: Einkaufsliste, Sicherheit/Masse, Druckteile,
    Spulen wickeln, Verdrahtungslisten Sender/Empfänger, Arduino-Setup,
    Messprogramm M1–M9 mit Oszilloskop, Erfolgskriterien K1–K7
    - docs/messprotokoll-phase3.md: Protokoll zum Ausfüllen
    - docs/machbarkeitstest-uebersicht.html: visuelle Übersicht mit Schaltplänen
    - firmware/machbarkeit: Test-Sketche Sender (ESP32-S2, DAC-Zweiton) und
    Empfänger (ESP32-S3, PCM1808, Lock-in, Frequenzsuche, AFC, Stromrichtung,
    Links/Rechts, Zangen-Modus, OLED, serieller Plotter); lockin.h mit
    Simulationstest und Syntaxprüfung auf dem PC (test_ho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
    [messkopf.scad, messkopf.stl, spulenkoerper.scad, spulenkoerper_H.stl, spulenkoerper_V.stl, wickeldorn.scad, wickeldorn.stl]
2026-10-13 Handgerät mit Abtastfläche oben, Vorschlag Variante „Einfach“
    - gehaeuse/konzept: Ansichtsmodell (OpenSCAD) mit Sensorkopf oben, Röntgenansicht, Sender einfach, Bilder
    - docs/variante-einfach.md: was bleibt, was fliegt, Kosten ca. 35 € pro Satz, Antwort zu „eine Platine“
    - entscheidungen: E-033 Abtastfläche oben (beschlossen), E-034 Variante „Einfach“ (vorgeschlagen)
    - README: Phase 3 angehalten bis zur Freigabe
    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
    [ansicht.scad]
2026-10-13 Variante „Einfach“ freigegeben: Mini-Test, Firmware, Schaltpläne
    - entscheidungen: E-034 beschlossen (OLED in beiden Geräten, Platine, zweite Spule vorbereitet),
    neue E-035 bis E-041, überholte Einträge mit neuem Status
    - Handgerät-Firmware: eingebauter Wandler des ESP32-S3, zwei Verstärkerstufen mit automatischer
    Bereichswahl (lockin::DualRange), gemessene Abtastrate, OLED mit dB/Balken/Stromrichtung,
    Piezo, Tasten REF und MODUS
    - Sender-Firmware: OLED mit Strom in mA, Strommessung über 10-Ω-Messwiderstand,
    Strombegrenzung, Taste PEGEL, Prüfton 1 kHz
    - PC-Simulation der ganzen Kette (Spule, Verstärker, 12-bit-Wandler): 7 Tests bestanden
    - Schaltpläne Sender und Handge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
    [ansicht.scad]
2026-10-13 Lochraster statt eigener Platine (E-042)
    - entscheidungen: E-042 neu (Lochraster, Phase 5 als Aufbauplan), E-034 V-3 geändert,
    E-014/E-026/E-031 mit neuem Status; Kosten ca. 31 € pro Satz
    - variante-einfach, machbarkeitstest (Einkauf mit Lochraster und Leisten), README
    - Übersichtsseiten aktualisiert
    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
2026-10-13 KiCad-Entwurf beider Platinen, Lastenheft und Konzept v2.0, DAC an GPIO18
    - hardware/kicad: Schaltplan und Platine für Sender (80 x 60 mm) und Handgerät (34 x 70 mm),
    2 Lagen, nur bedrahtete Teile, mit Freerouting vollständig geroutet, DRC ohne elektrische Fehler,
    Gerber, Bilder; erzeugt per Skript aus netze.py und platzierung.py
    - docs/platine-oder-lochraster: Vergleich, Kosten, Empfehlung, Prüfliste vor einer Bestellung
    - Lastenheft v2.0 und Konzept v2.0 auf Variante „Einfach“ mit Lochraster (31 € pro Satz)
    - Sender: Signalausgang an GPIO18 (äußere Stiftreihe) statt GPIO17 (E-043)
    - entscheidungen: E-043, E-044 (KiCad-Entwurf, Entscheidung offen)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
    [handgeraet.kicad_pcb, handgeraet.kicad_sch, sender.kicad_pcb, sender.kicad_sch]
